yama1770/MZ-2000SIO/README.md

MZ-2000SIO拡張基板

IPLROMをMZ-2000IPL.hexに書き換える。
ｼﾘｱﾙ通信とROM起動が行える。
ROM起動は最大4個まで登録可能。
起動時に/,A,B,Dのどれかのｷｰを押すことにより選択可能。
8255はNEC制(UPD8255)を使用してください、東芝製は動作しませんでした。
