yama1770/MZ-2000SIO/MZ-2000SIO.pdf

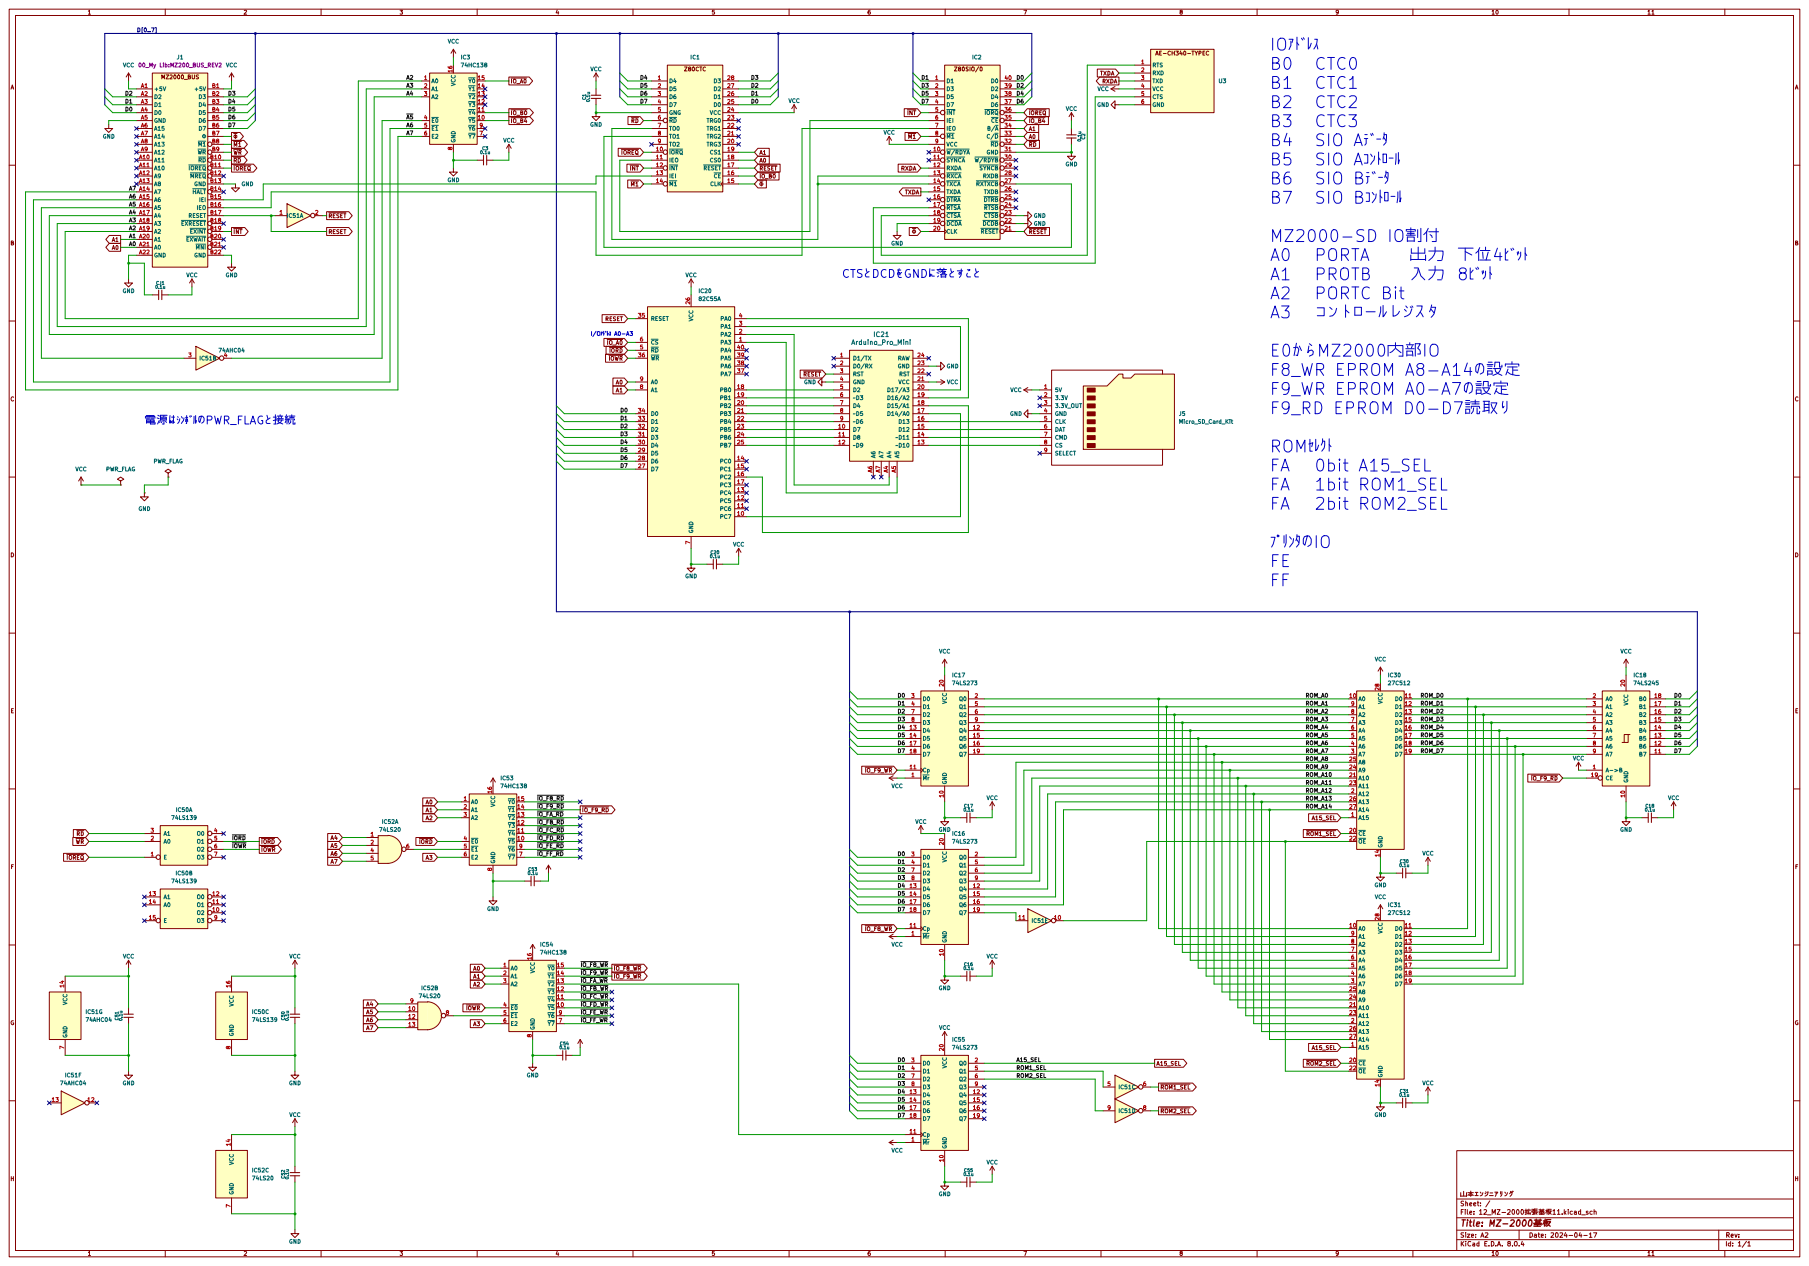
[picture p1: page 1]
